UnlimitedY/wireless_neural_signal_recording_mouse/README.md

# wireless_neural_signal_recording_mouse
