UnlimitedY/wireless_neural_signal_recording_mouse/wireless_headstage_omnetics_PCB/nrf贴片omnetics 20250423/nrf贴片omnetics/器件方向.docx

U6：右上

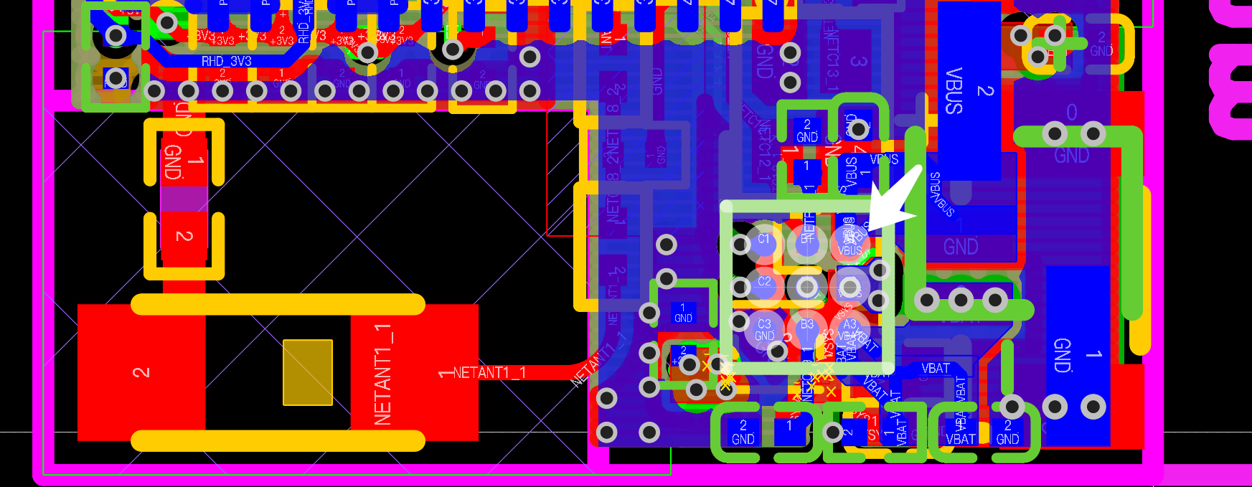
[picture p11: figure]

U1：右下

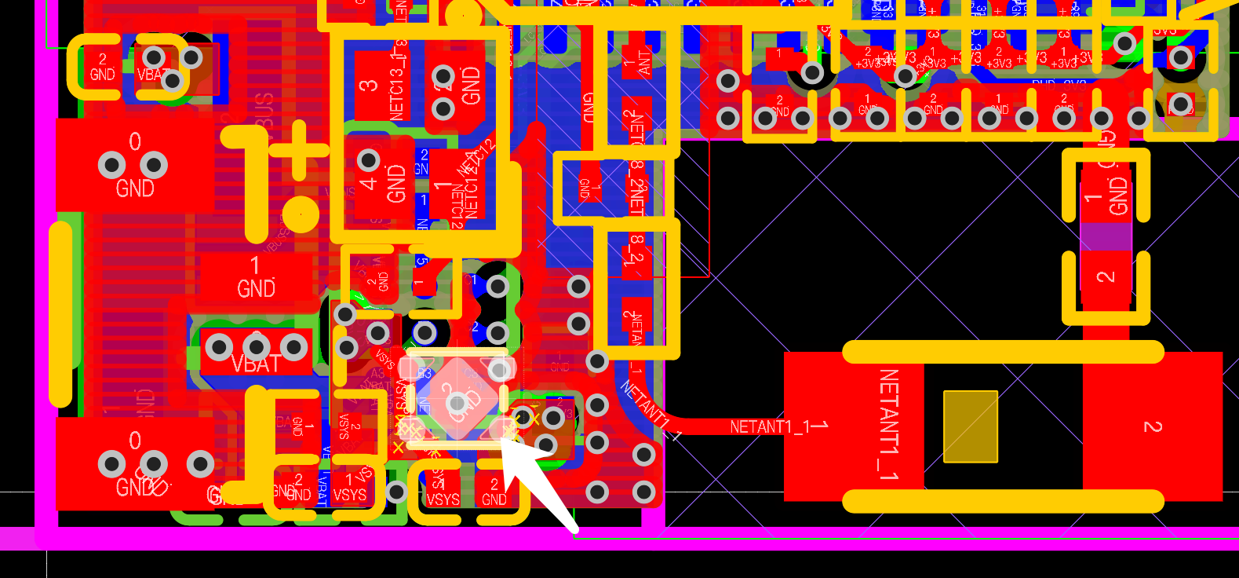
[picture p12: figure]

U2： 左下

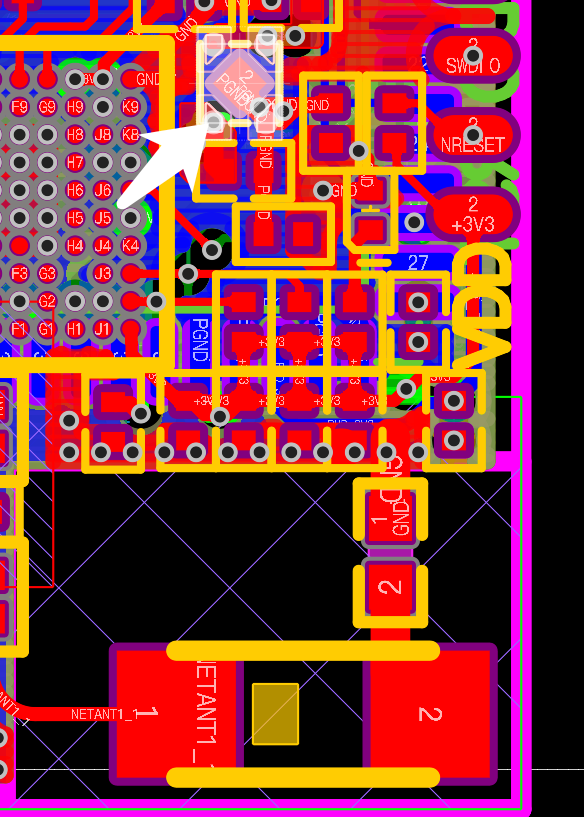
[picture p13: figure]

LED1：RED

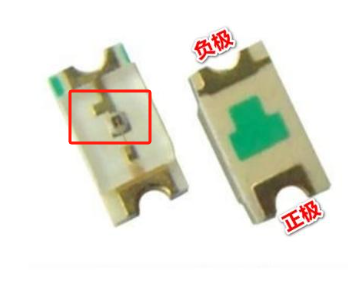
[picture p14: figure]
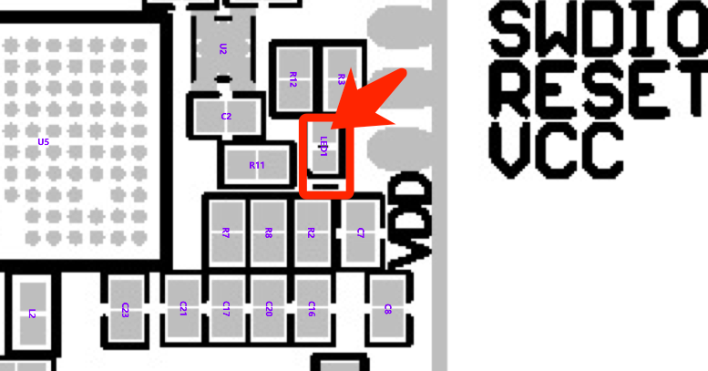
[picture p15: figure]

LED2：Blue or Green

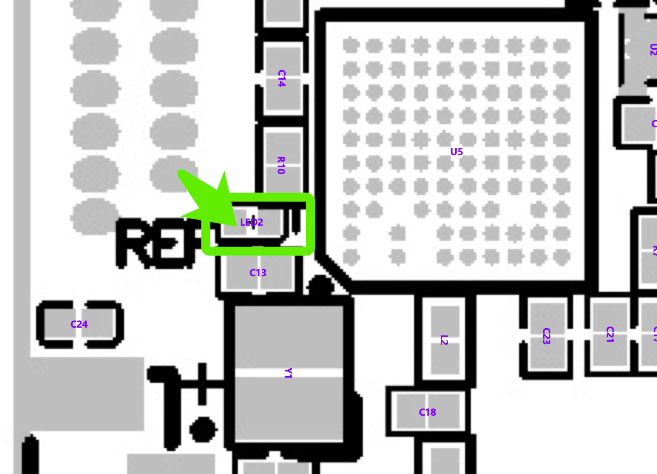
[picture p16: figure]
