UnlimitedY/wireless_neural_signal_recording_mouse/GUI/QtESBV4/Pre-experiements-behavioral-task/DBRuleSwitch/readme.txt

对于研究全天候的学习过程
需要trial的结构在整个学习过程中不发生改变

这里的范式通过提前训练一个 attend location范式来让小鼠
完成trial结构的学习并熟悉后续的freq 刺激
【inhibitation 过程，只要放进去就持续有三个led亮，出来就不亮， go cue
3KHz，对于sample period的抑制也慢慢增加时间来训练，从100ms到500ms；
增加delay 的随机性，不要固定在200ms】

之后主要关心从attend to location 到 attend to freq (5个contrasts，8~32KHz)
 的过程作为研究
学习过程主要的数据来源和attend to reverse freq的过程（这段时间
trial 结构没有发生变化，数据更加的稳定）

加入catch trials和 contrast
1. baseline trial （no sample no reward； 5%）,trial block中第一个trial
2. catch trial（contrast 为 0 ，random reward对于freq 刺激，在一开始就加入
70% perf threshold）

使用antibias （60%概率复制上一个 最简单的error trials 的所有参数 ）
Testing protocol 直接使用random
