UnlimitedY/wireless_neural_signal_recording_mouse/GUI/QtESBV4/ThermalSupervisor/mlx90640-mini热像仪采集记录仪新/Ubuntu20(AMD64)/ubuntu运行软件简要说明.docx

运行软件 切换到root 需要获取串口信息前提

sudo ./AppRun

安装CH340驱动

sudo make

sudo make install

echo $? 看下返回0 安装成功

lsusb 看下有没有串口设备 前提插入了电脑USB

打开软件，第一次运行会隐藏功能界面， 点上面 软件配置， 去掉所有勾选。
