UnlimitedY/wireless_neural_signal_recording_mouse/wireless_headstage_omnetics_PCB/nrf贴片omnetics 20250423/nrf贴片omnetics/BOM_Power_rhd2132_20250418_2025-04-23.xlsx

Sheet: bom模板
 |  |  |  | Bill of Materials | BOM_Power_rhd2132_20250418_2025-04-23
 |  |  |  | Project Title： | NRF-RHD_V0.3_1813 200250418
 |  |  |  | Variant:
 |  |  |  | Report Time： | 2025年4月23日 14:12:39
No. | Quantity | Comment | Designator | Footprint | Value | Manufacturer Part | Manufacturer | Supplier Part | Supplier | LCSC Price | Total
1 | 1 | ANT1 | ANT1 | ANT-SMD_2P-L3.20-W1.60 |  |  |  |  |  |  | #VALUE!
2 | 4 | 1uF | C1, C2, C3, C4 | C 0201_L |  |  |  |  |  |  | #VALUE!
3 | 3 | 0.1uF/16V | C5, C8, C9 | C 0201_L |  |  |  |  |  |  | #VALUE!
4 | 1 | 1uF/16V | C6 | C 0201_L |  |  |  |  |  |  | #VALUE!
5 | 1 | 10nF | C7 | C 0201_L |  |  |  |  |  |  | #VALUE!
6 | 2 | 100nF | C10, C11 | C 0201_L |  |  |  |  |  |  | #VALUE!
7 | 2 | 12pF | C12, C13 | C 0201_L |  |  |  |  |  |  | #VALUE!
8 | 2 | 1.0uF | C14, C17 | C 0201_L |  |  |  |  |  |  | #VALUE!
9 | 4 | 0.1uF | C15, C16, C21, C22 | C 0201_L |  |  |  |  |  |  | #VALUE!
10 | 1 | 1.0pF | C18 | C 0201_L |  |  |  |  |  |  | #VALUE!
11 | 1 | 4.7uF | C20 | C 0201_L |  |  |  |  |  |  | #VALUE!
12 | 1 | 820pF | C23 | C 0201_L |  |  |  |  |  |  | #VALUE!
13 | 2 | 4.7uF | C24, C26 | 0201(C) |  |  |  |  |  |  | #VALUE!
14 | 3 | 0.1uF | C25, C27, C29 | 0201(C) |  |  |  |  |  |  | #VALUE!
15 | 1 | 2.2uF/35V | C28 | 0201(C) |  |  |  |  |  |  | #VALUE!
16 | 1 | B79038 | J1 | B79038 |  |  |  |  |  |  | #VALUE!
17 | 1 | 4.7nH | L1 | L0201 |  |  |  |  |  |  | #VALUE!
18 | 1 | 3.9nH | L2 | L0201 |  |  |  |  |  |  | #VALUE!
19 | 2 | RED & Green | LED1, LED2 | LED-SMD_L0.7-W0.4-RD_BLUE - duplicate |  |  |  |  |  |  | #VALUE!
20 | 1 | power | P1 | CONN-SMD_SM02B-SURS-TF-LF-SN - duplicate |  |  |  |  |  |  | #VALUE!
21 | 1 | power | P2 | HDR-SMD_2P-P1.27-V-M-LS4.2-R1 |  |  |  |  |  |  | #VALUE!
22 | 4 | 10K | R2, R7, R8, R10 | R 0201_L |  |  |  |  |  |  | #VALUE!
23 | 1 | 100K | R3 | R 0201_L |  |  |  |  |  |  | #VALUE!
24 | 4 | 33o | R4, R5, R6, R9 | R 0201_L |  |  |  |  |  |  | #VALUE!
25 | 2 | 0R | R11, R12 | R 0201_L |  |  |  |  |  |  | #VALUE!
26 | 1 | 0R | R13 | 0402(R) |  |  |  |  |  |  | #VALUE!
27 | 1 | 1M | R14 | 0201(R) |  |  |  |  |  |  | #VALUE!
28 | 1 | NTC-10K | R15 | 0201(R) |  |  |  |  |  |  | #VALUE!
29 | 2 | TPS7A2033PDQNR | U1, U2 | X2SON-0.4 |  |  |  |  |  |  | #VALUE!
30 | 1 | RHD2132 | U3 | QFN-56-9mm |  |  |  |  |  |  | #VALUE!
31 | 1 | LSM6DS3TR | U4 | LAG-14 |  |  |  |  |  |  | #VALUE!
32 | 1 | NRF52840-CKAA-R7 | U5 | BGA94C35P10X10_354X361X51 |  |  |  |  |  |  | #VALUE!
33 | 1 | MP2710GC-0000 | U6 | WLCSP3*3-P0.5mm |  |  |  |  |  |  | #VALUE!
34 | 1 | 32MHz | Y1 | OSC 1612-4P |  |  |  |  |  |  | #VALUE!
35 | #VALUE!

Sheet: Field汇总
Project Title | NRF-RHD_V0.3_1813 200250418
Borard Title | Power
Schematic Title
PCB Title | rhd2132_20250418
Variant Name
Total Quantity | 57
Report Time | 14:12:39
Report Date | 2025年4月23日
Report Date&Time | 2025年4月23日 14:12:39
File Name | BOM_Power_rhd2132_20250418_2025-04-23
Filter Option | Add into BOM:no;
