UnlimitedY/wireless_neural_signal_recording_mouse/GUI/QtESBV4/ThermalSupervisor/mlx90640-mini热像仪采集记录仪新/模块数据手册/3DSTL/PCB2.step

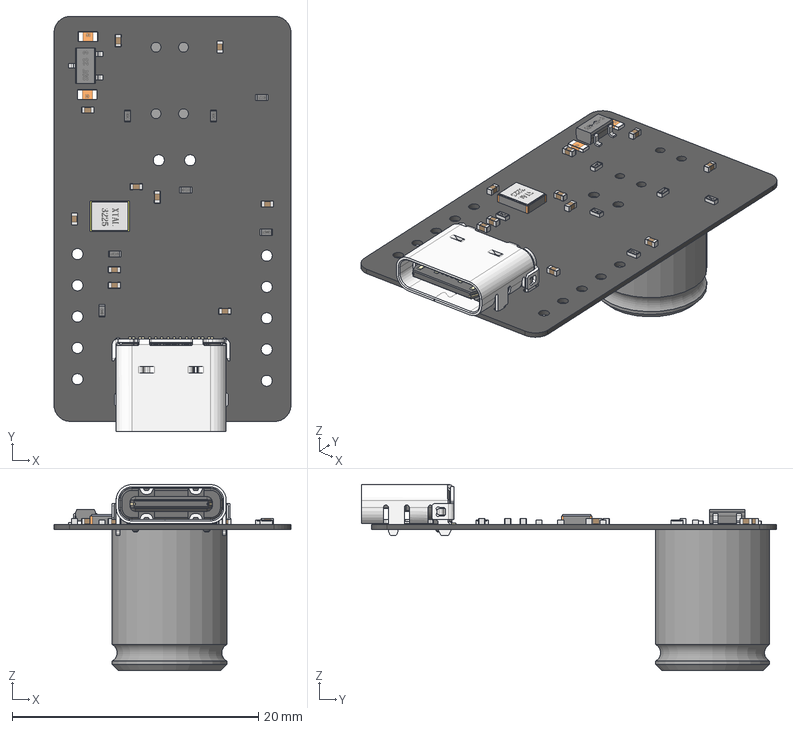
[picture p17: CAD file, 2026-01-29]
GUI/QtESBV4/ThermalSupervisor/mlx90640-mini热像仪采集记录仪新/模块数据手册/3DSTL/PCB2.step
19.2 x 33.7 x 15.1 mm
