UnlimitedY/wireless_neural_signal_recording_mouse/GUI/QtESBV4/ThermalSupervisor/mlx90640-mini热像仪采集记录仪新/模块数据手册/3DSTL/477787072570855504.step

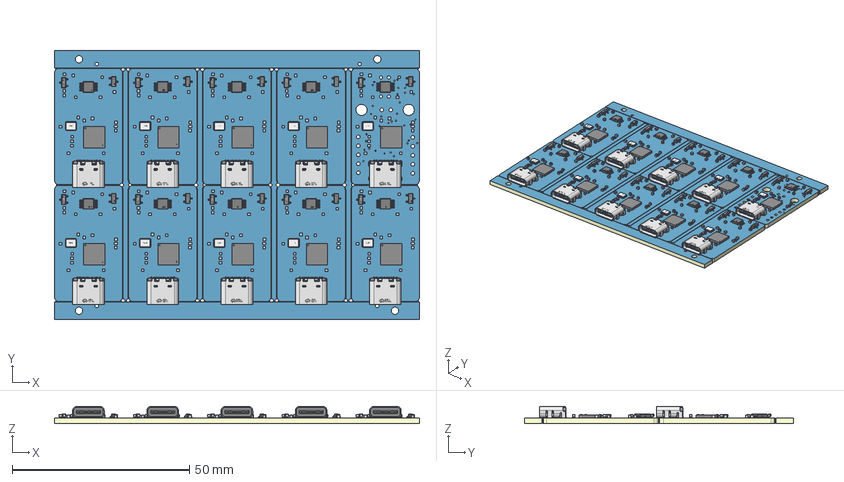
[picture p18: CAD file, 2026-01-29]
GUI/QtESBV4/ThermalSupervisor/mlx90640-mini热像仪采集记录仪新/模块数据手册/3DSTL/477787072570855504.step
103.1 x 75.9 x 4.85 mm
Board~Kfwh
TopCopper~Kfwh
BottomCopper~Kfwh
TopFpcStiffener~Kfwh
BottomFpcStiffener~Kfwh
C2~0603~ac9b32e974bc448eab36b1293f859dcb~Kfwh x 20
C6~0402~32fe2cf9314f444ca2785a33c2db7189~Kfwh x 100
R7~0402~026a4a15ab5c4a92ac0e421d6d013717~Kfwh x 70
SOT-23-3~d777607a152f4f3aac9bb0d0c14ed6fd~Kfwh x 10
SOT-23~d777607a152f4f3aac9bb0d0c14ed6fd~Kfwh x 10
SMD~954b2a5828604707b62aef0fe6e7695f~Kfwh x 10
QFN-36-EP(6x6)~9249f52d05404403ac352f33043cef56~Kfwh x 10
0402~ccb4f96094b249eaba587e4fe24b6f07~Kfwh x 10
MSOP-10~a8ab40c7a7c54773a59b712bf86c7131~Kfwh x 10
SMD3225-4P~02485e56ba8d4732a26526d2983fc729~Kfwh x 10
