UnlimitedY/wireless_neural_signal_recording_mouse/wireless_headstage_omnetics_PCB/nrf贴片omnetics 20250423/nrf贴片omnetics/rhd2132_20250418_装配图.pdf

# 时间：2025-04-23装配图纸_top

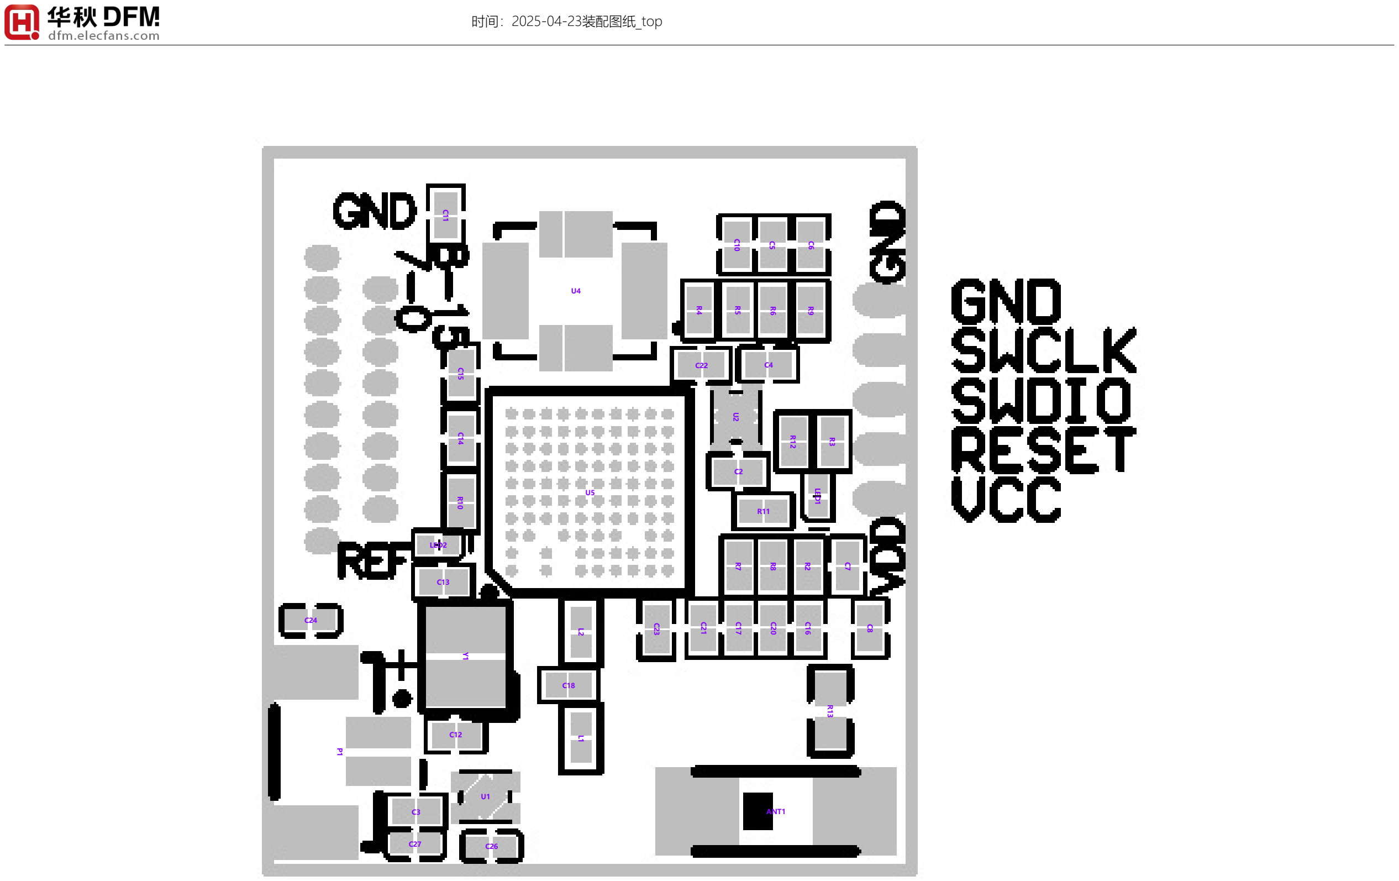
[picture p19: page 1]

ANT1

C10

C11 C12

C13

C14 C15

C16

C17

C18

C2

C20

C21 C22

C23

C24

C26 C27

C3

C4

C5

C6

C7

C8
L1 L2

LED1

LED2

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
# 时间：2025-04-23装配图纸_bot

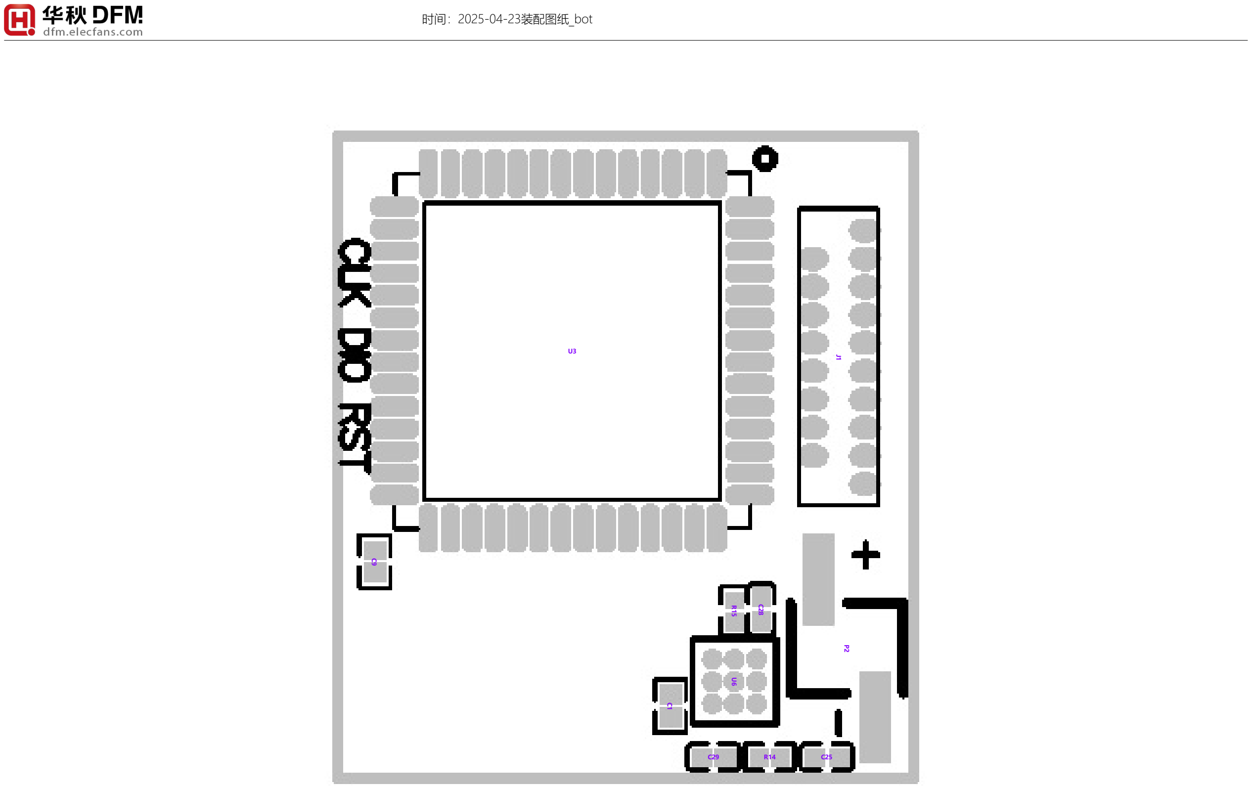
[picture p20: page 2]

C1

C25

C28

C29

C9

J1 P2

R14

R15

U3

U6
