UnlimitedY/wireless_neural_signal_recording_mouse/other_maybe_useful/NRF_RHD2132_1813.pdf

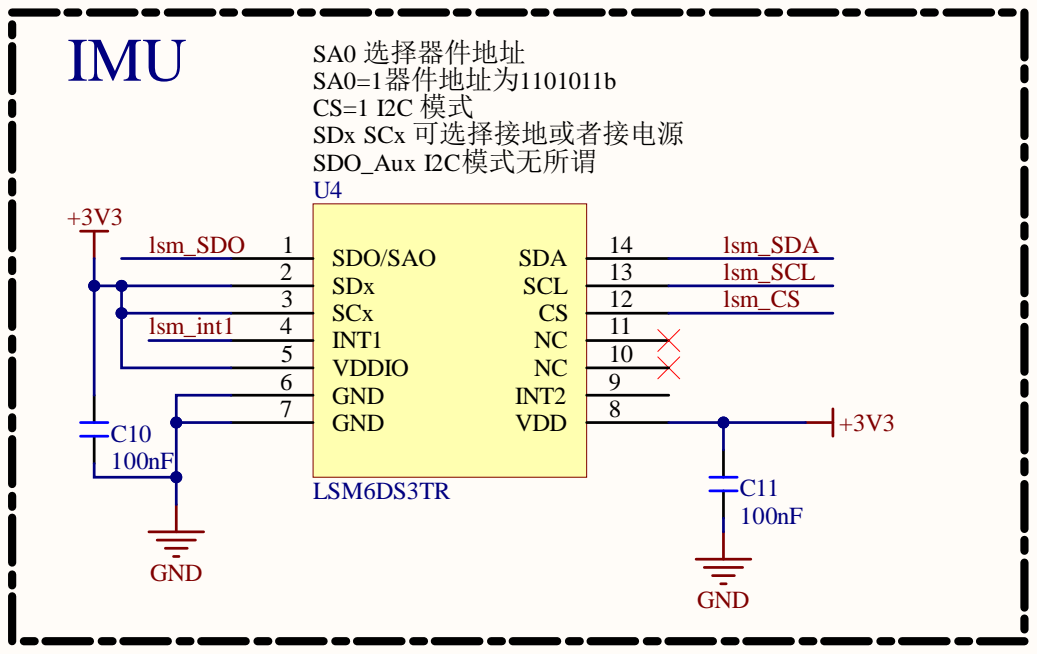
[picture p21: page 1]

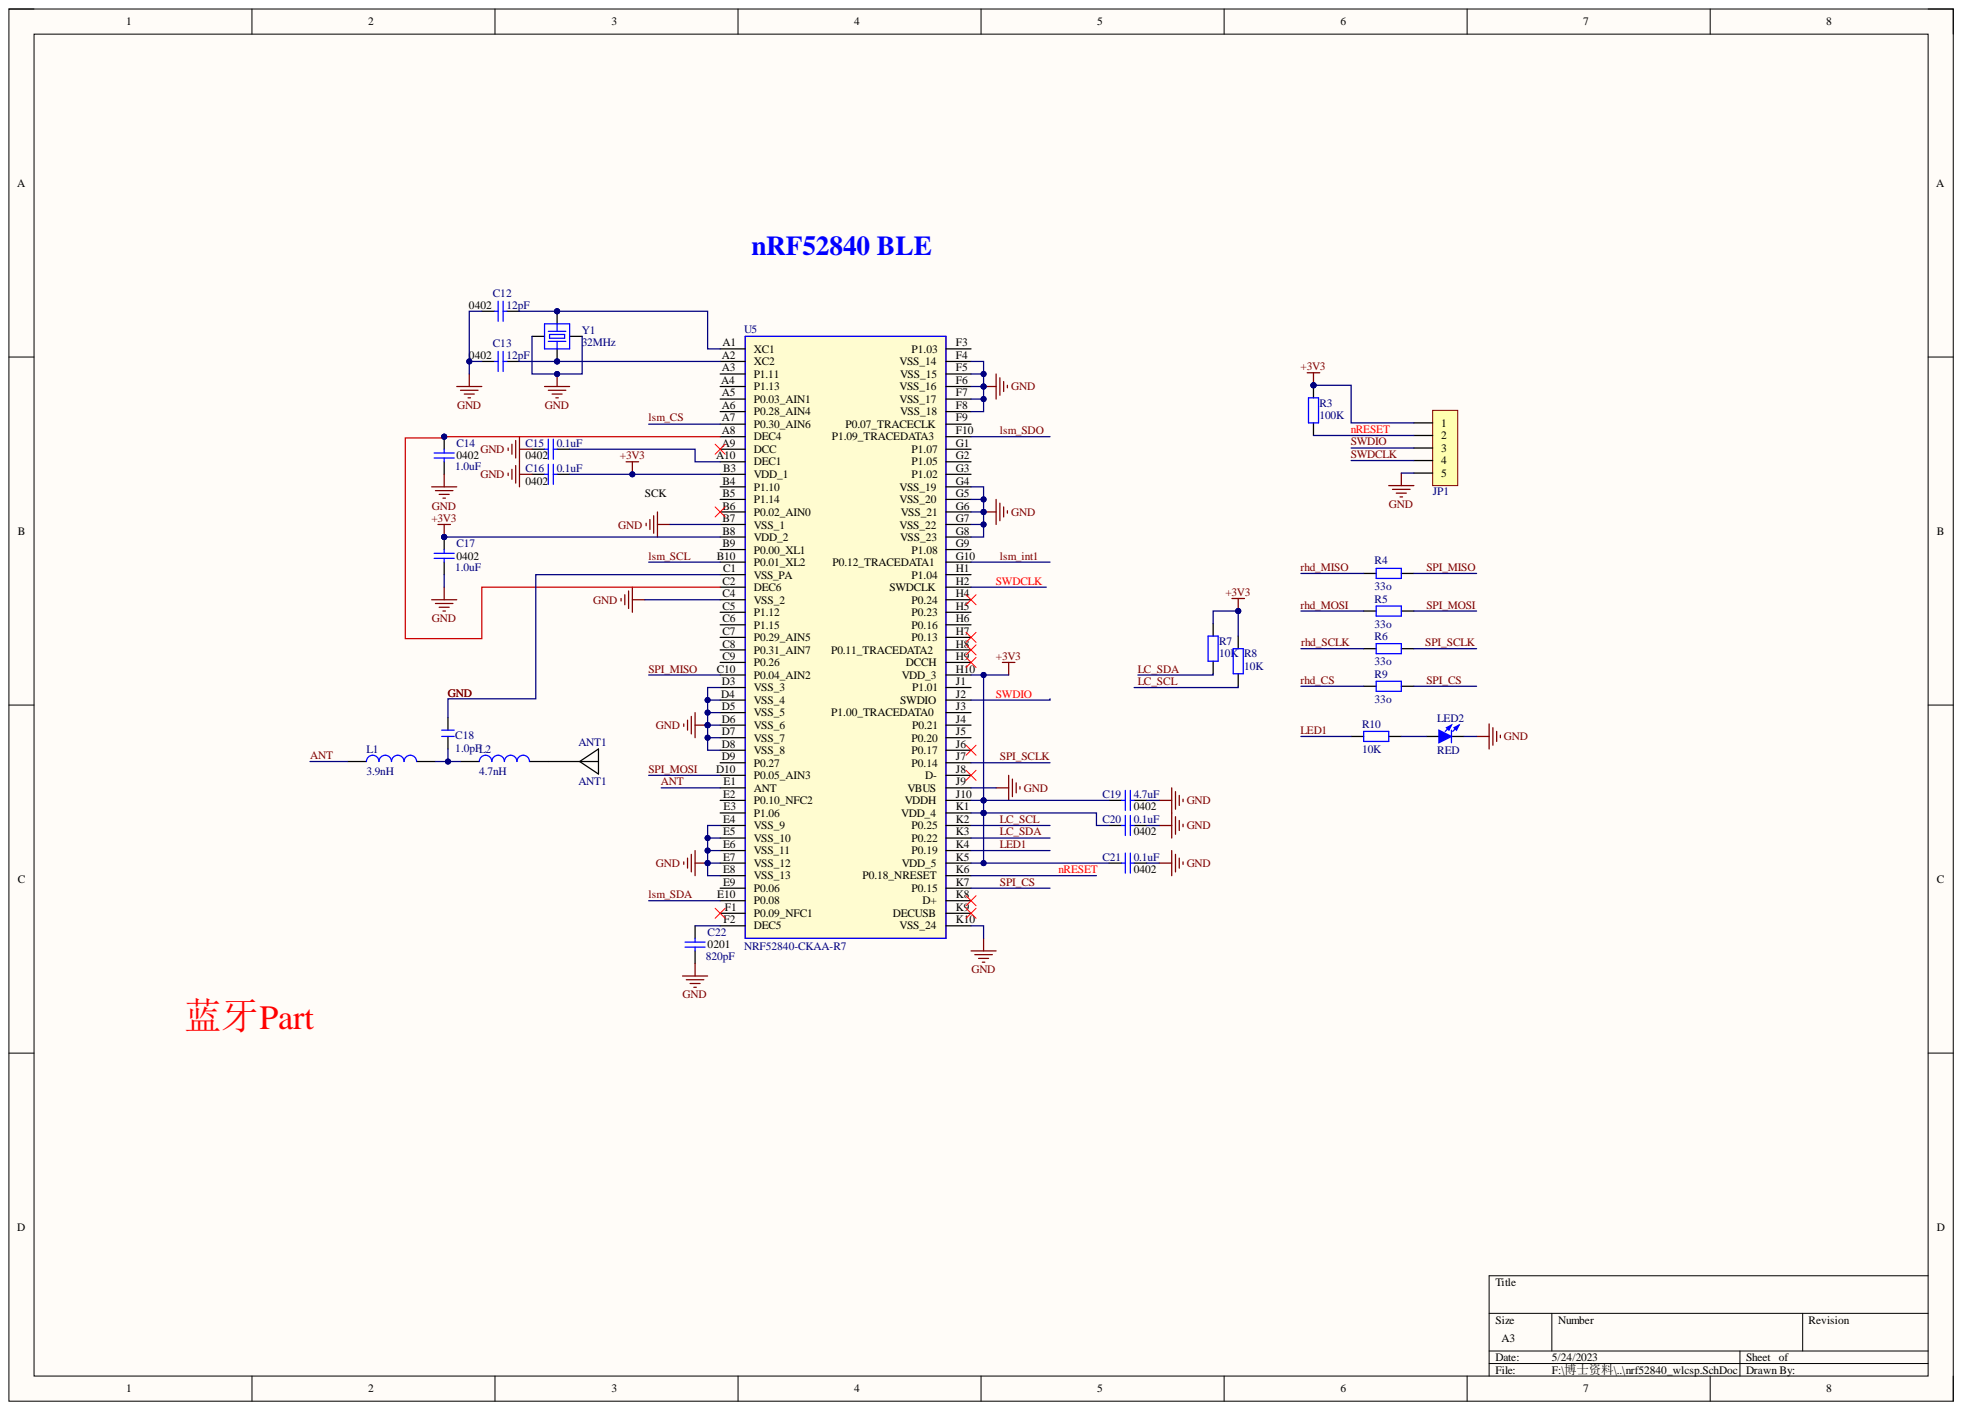
[picture p22: page 2]

C 2
C 4

SPI_M ISO | C 5 | | H 5

C 7 | | H 7
C 8 | | H 8
C 9 | | H 9
C10 | | H10
D 3 | | J 1

D 4 | | J 2 J 3
D 5
D 6 | | J 4
D 7 | | J 5

J10
K 1
K 2 | LC_SC L

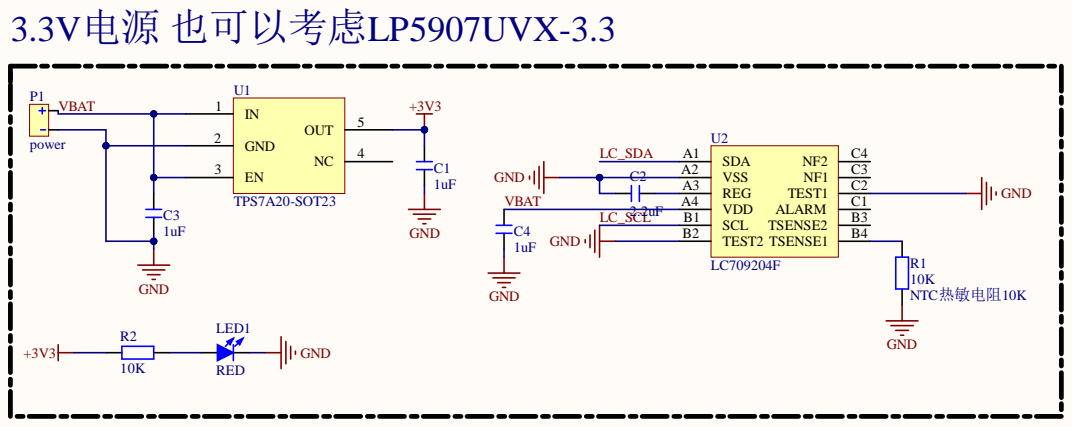
[picture p23: page 3]

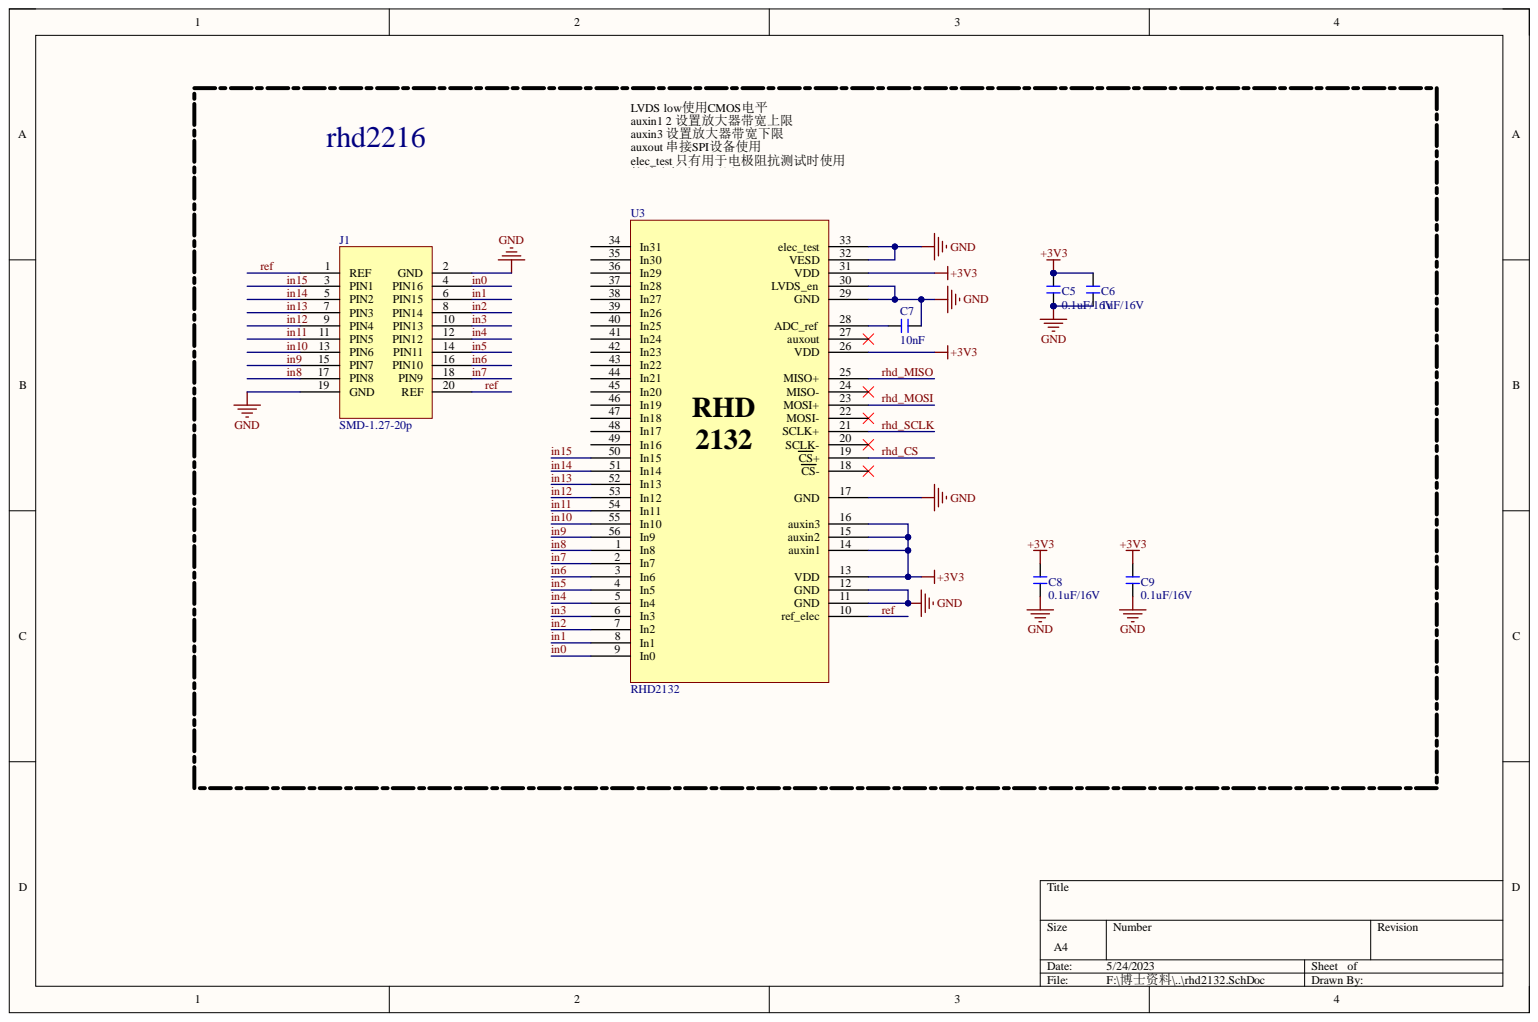
[picture p24: page 4]

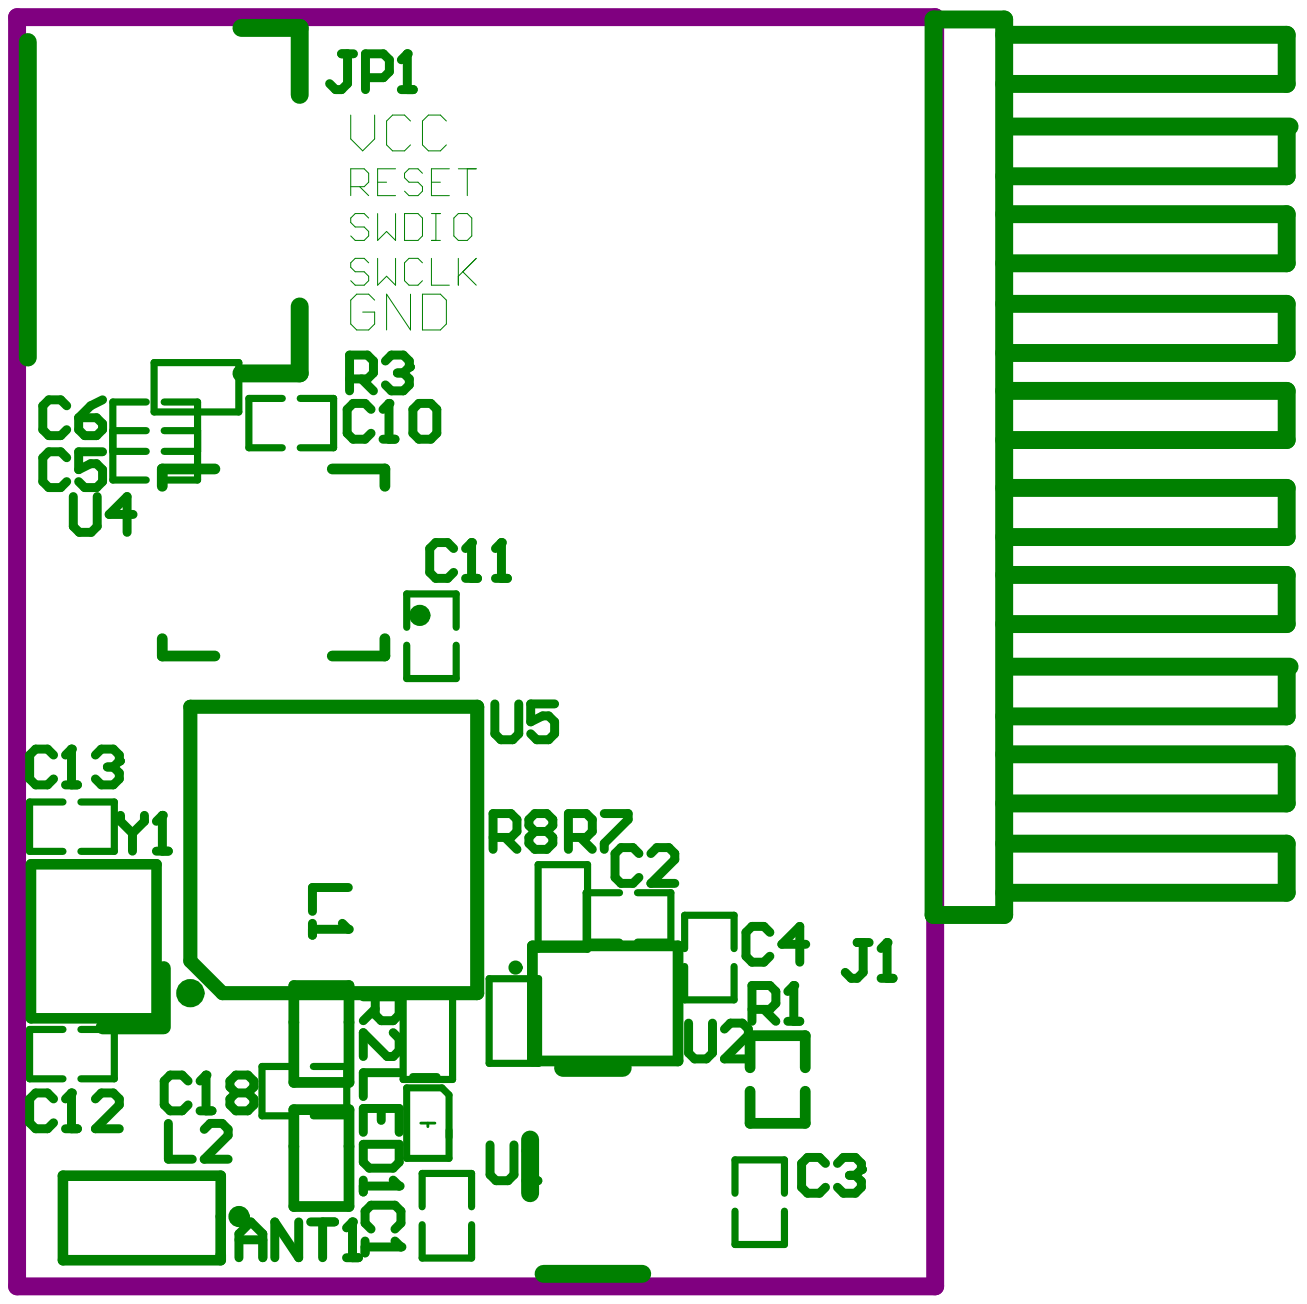
[picture p25: page 5]

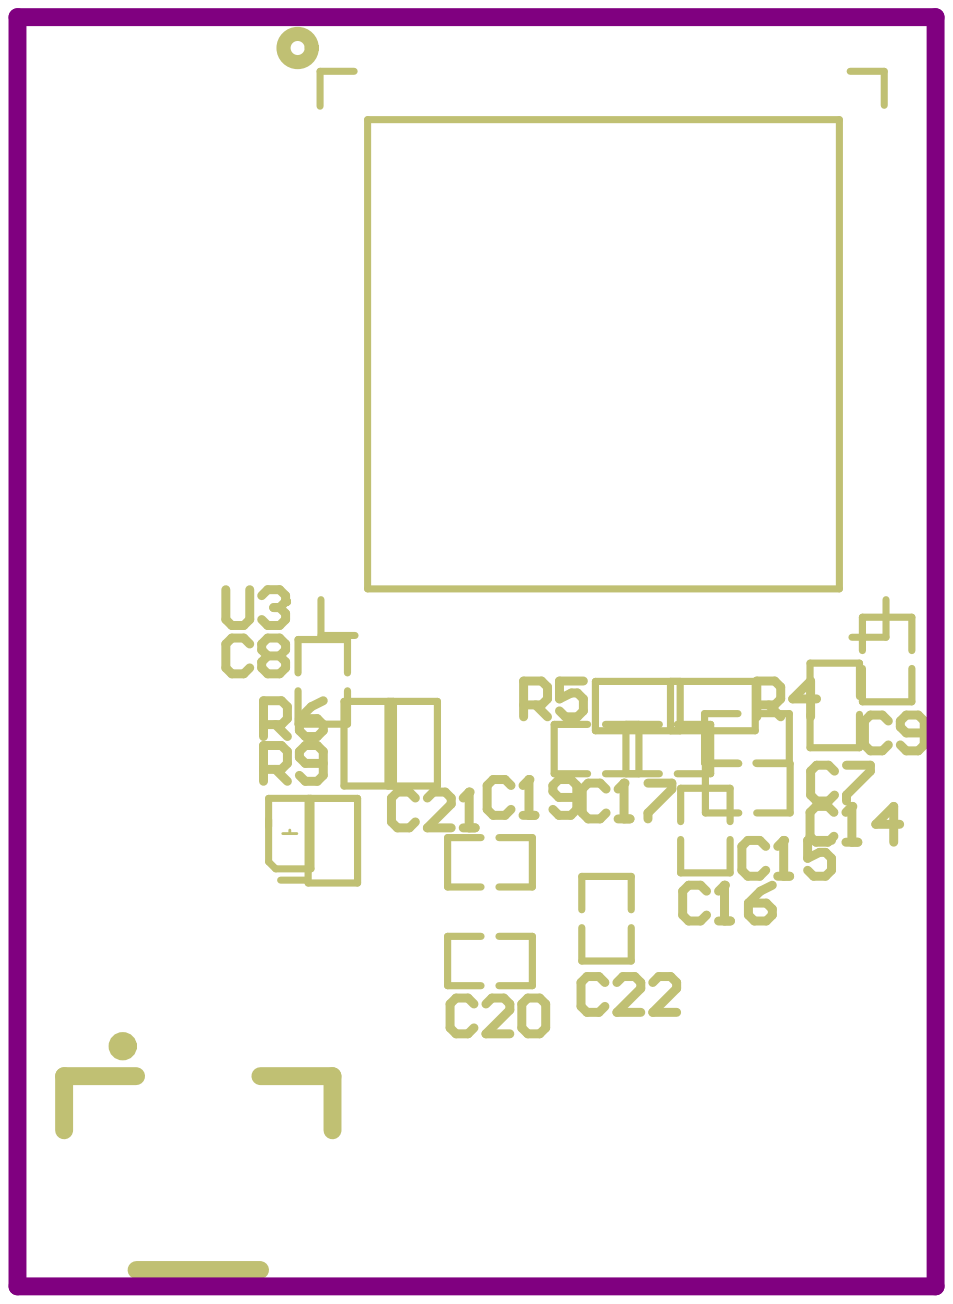
[picture p26: page 6]
