UnlimitedY/wireless_neural_signal_recording_mouse/(list of files, drawings)

Other design files:
other_maybe_useful/WPT_FPC_XCM_Change(1)(1).pcbdoc
wireless_headstage_omnetics_PCB/nrf贴片omnetics 20250423/nrf贴片omnetics/pcb&sch/IMU.SchDoc
wireless_headstage_omnetics_PCB/nrf贴片omnetics 20250423/nrf贴片omnetics/pcb&sch/nrf52840_wlcsp.SchDoc
wireless_headstage_omnetics_PCB/nrf贴片omnetics 20250423/nrf贴片omnetics/pcb&sch/NRF_RHD2132_1813_YBW.PrjPcb
wireless_headstage_omnetics_PCB/nrf贴片omnetics 20250423/nrf贴片omnetics/pcb&sch/Power.SchDoc
wireless_headstage_omnetics_PCB/nrf贴片omnetics 20250423/nrf贴片omnetics/pcb&sch/rhd2132.SchDoc
wireless_headstage_omnetics_PCB/nrf贴片omnetics 20250423/nrf贴片omnetics/pcb&sch/rhd2132_20250418.PcbDoc
