UnlimitedY/wireless_neural_signal_recording_mouse/firmware/pripherial/Sensor_recording/LSM6DS3.c

/**
 * LSM6DS3.h
 *
 * nRF52 TWI interface for LSM6DS3 IMU.
 *
 * Electronut Labs
 * electronut.in
 */

#include "stdlib.h"
#include "time.h"
#include "LSM6DS3.h"

/**
 * @brief function to test availablility of IMU by reading WHO_AM_I register.
 */
int LSM6DS3_who_am_i(void)
{
  nrfx_err_t err_code;
  uint8_t who_am_i = 10;
  bool is_busy = 1;
  err_code = data_read(WHO_AM_I, &who_am_i, 1, 1);

  if(who_am_i !=0x6A){
    return who_am_i;
  }else{
    return -1;
  }
  // return err_code;
  // APP_ERROR_CHECK(err_code);
}


/**
 * @brief function to initialize IMU sensor.
 */
uint8_t LSM6DS3_init(void)
{
  uint8_t err_code;
  settings.accel_range            = 2;      // Full Scale(FS) range (in g). Select from: 2, 4, 8, 16
  settings.accel_samplerate       = 104;    // Hz. Select from: 13, 26, 52, 104, 208, 416, 833, 1666
  settings.accel_bandwidth        = 400;    // Hz. Select from: 50, 100, 200, 400
  settings.accel_FIFO_enable      = 0;      // Set to include accelerometer data in FIFO buffer
  settings.accel_FIFO_decimation  = 0;      // Set to activate.

  settings.gyro_range             = 500;   // Angular Rate range (in deg/s).  Can be: 125, 245, 500, 1000, 2000
	settings.gyro_samplerate        = 104;    // Hz. Select from: 13, 26, 52, 104, 208, 416, 833, 1666
	settings.gyro_bandwidth         = 400;    // Hz. Select from: 50, 100, 200, 400;
	settings.gyro_FIFO_enable       = 0;      // Set to include gyroscope data in FIFO buffer
	settings.gyro_FIFO_decimation   = 0;      // Set to activate.

	settings.temp_enable            = 0;      // Set to activate temperature measure

	//FIFO control data
	settings.FIFO_threshold 			  = 3000;    //Can be 0 to 4096 (16 bit bytes)
	settings.FIFO_samplerate 		    = 13;     //default 13Hz
	settings.FIFO_mode 			        = 6;      //Default off

  // 注意： 这里要disable iic 的bus ，否则会导致漏电功耗上升
  uint8_t tx_data[2] = {MASTER_CONFIG, 0x00};
  err_code = data_write(tx_data[0] ,&tx_data[1], 1, 1);
  // set IF_INC in CTRL3_C register. set BDU : block mode for low-power
  tx_data[0] = CTRL3_C;
  tx_data[1] = 0x44;
  err_code = data_write(tx_data[0], &tx_data[1] ,1, 1);

  err_code = LSM6DS3_config();
  return err_code;
}

/**
 * @brief function to configure IMU parameters.
 *
 * Accelerometer parameters are configured using CTRL1_XL register.
 * Bit[1:0] are reserved for filter bandwidth selection. Values can be 400 Hz, 200 Hz, 100 Hz and 50 Hz
 * Bit[3:2] are reserved for full scale range selection. Values can be (+/-)2g, (+/-)4g, (+/-)8g and (+/-)16g
 * Bit[7:4] are reserved for output data rate and power mode selection.
 *
 * Gyroscope parameters are configured using CTRL2_G registers.
 * Bit[1] is reserved for full scale range selection at 125 dps.
 * Bit[3:2] are reserved for full scale range sselection from 245 dps, 500 dps, 1000 dps and 2000 dps
 * Bit[7:4] are reserved for output data rate selection.
 */
uint8_t LSM6DS3_config(void)
{
  nrfx_err_t err_code;
  uint8_t tx_data[2];

  // configure accelerometer
  tx_data[0] = CTRL1_XL;
  tx_data[1] = 0;
  if(settings.accel_enable == 1) {
    // Bandwidth lowpass filter
    switch(settings.accel_bandwidth) {
      case 50:
              tx_data[1] |= LSM6DS3_IMU_BW_XL_50Hz;
              break;

      case 100:
              tx_data[1] |= LSM6DS3_IMU_BW_XL_100Hz;
              break;

      case 200:
              tx_data[1] |= LSM6DS3_IMU_BW_XL_200Hz;
              break;

      default:
      case 400:
              tx_data[1] |= LSM6DS3_IMU_BW_XL_400Hz;
              break;
    }

    // Full scale range
    switch(settings.accel_range) {
      case 2:
              tx_data[1] |= LSM6DS3_IMU_FS_XL_2g;
              break;

      case 4:
              tx_data[1] |= LSM6DS3_IMU_FS_XL_4g;
              break;

      case 8:
              tx_data[1] |= LSM6DS3_IMU_FS_XL_8g;
              break;

      default:
      case 16:
              tx_data[1] |= LSM6DS3_IMU_FS_XL_16g;
              break;
    }

    // ODR
    switch(settings.accel_samplerate) {

      case 0:
              tx_data[1] |= LSM6DS3_IMU_ODR_XL_POWER_DOWN;
              break;

      case 13:
              tx_data[1] |= LSM6DS3_IMU_ODR_XL_13Hz;
              break;

      case 26:
              tx_data[1] |= LSM6DS3_IMU_ODR_XL_26Hz;
              break;

      case 52:
              tx_data[1] |= LSM6DS3_IMU_ODR_XL_52Hz;
              break;

      default:
      case 104:
              tx_data[1] |= LSM6DS3_IMU_ODR_XL_104Hz;
              break;

      case 208:
              tx_data[1] |= LSM6DS3_IMU_ODR_XL_208Hz;
              break;

      case 416:
              tx_data[1] |= LSM6DS3_IMU_ODR_XL_416Hz;
              break;

      case 833:
              tx_data[1] |= LSM6DS3_IMU_ODR_XL_833Hz;
              break;

      case 1660:
              tx_data[1] |= LSM6DS3_IMU_ODR_XL_1660Hz;
              break;

      case 3330:
              tx_data[1] |= LSM6DS3_IMU_ODR_XL_3330Hz;
              break;

      case 6660:
              tx_data[1] |= LSM6DS3_IMU_ODR_XL_6660Hz;
              break;
    }
  }
  else {
    tx_data[1] = 0;
  }

  err_code = data_write(tx_data[0], &tx_data[1] ,1, 1);

  // configure gyroscope
  tx_data[0] = CTRL2_G;
  tx_data[1] = 0;
  if(settings.gyro_enable == 1) {
    // range
    switch(settings.gyro_range) {
      case 125:
              tx_data[1] |= LSM6DS3_IMU_FS_125_ENABLED;
              break;

      case 245:
              tx_data[1] |= LSM6DS3_IMU_FS_G_245dps;
              break;

      case 500:
              tx_data[1] |= LSM6DS3_IMU_FS_G_500dps;
              break;

      case 1000:
              tx_data[1] |= LSM6DS3_IMU_FS_G_1000dps;
              break;

      default:
      case 2000:
              tx_data[1] |= LSM6DS3_IMU_FS_G_2000dps;
              break;
    }

    // ODR
    switch(settings.gyro_samplerate) {
      case 13:
              tx_data[1] |= LSM6DS3_IMU_ODR_G_13Hz;
              break;

      case 26:
              tx_data[1] |= LSM6DS3_IMU_ODR_G_26Hz;
              break;

      case 52:
              tx_data[1] |= LSM6DS3_IMU_ODR_G_52Hz;
              break;

      default:
      case 104:
              tx_data[1] |= LSM6DS3_IMU_ODR_G_104Hz;
              break;

      case 208:
              tx_data[1] |= LSM6DS3_IMU_ODR_G_208Hz;
              break;

      case 416:
              tx_data[1] |= LSM6DS3_IMU_ODR_G_416Hz;
              break;

      case 833:
              tx_data[1] |= LSM6DS3_IMU_ODR_G_833Hz;
              break;

      case 1660:
              tx_data[1] |= LSM6DS3_IMU_ODR_G_1660Hz;
              break;
    }
  }
  else {
    tx_data[1] = 0;
  }

  err_code = data_write(tx_data[0], &tx_data[1] ,1, 1);
  
  if(settings.accel_enable){
    LSM6DS3_set_accel_normal_mode(settings.accel_samplerate);
  }else{
    LSM6DS3_set_accel_power_down_mode();
  }

  if(settings.gyro_enable){
    LSM6DS3_set_gyro_active_mode();
  }else{
    LSM6DS3_set_gyro_sleep_mode();
  }
  uint8_t config_return = 0;

  return config_return;
}


void LSM6DS3_accel_enable(void)
{
}

void LSM6DS3_gyro_enable(void)
{
}

/**
 * @brief function to enable power down mode in accelerometer
 *
 * setting ODR_XL[3:0] in CTRL1_XL register to 0 enables power-down mode.
 */
void LSM6DS3_set_accel_power_down_mode()
{
  nrfx_err_t err_code;
  uint8_t rx_data;
  uint8_t tx_data[2] = {CTRL1_XL, 0};

  // read CTRL1_XL register to obtain current parameters.
  // err_code = data_read(CTRL1_XL, &rx_data, sizeof(rx_data), 1);
  err_code = data_read(CTRL1_XL, &rx_data, sizeof(rx_data), 1);
  
  // APP_ERROR_CHECK(err_code);

  // bit mask CTRL1_XL to avoid losing previously set parameters. Only change ODR_XL bits.
  tx_data[1] |= (0x00 << 4) | (rx_data & 0x0F);

  err_code = data_write(tx_data[0], &tx_data[1] ,1, 1);
  // APP_ERROR_CHECK(err_code);
}

/**
 * @brief function to enable low power mode in accelerometer
 *
 * Low power mode is enabled by setting one of the following ODR values: 13 Hz, 26Hz and 52 Hz
 */
void LSM6DS3_set_accel_low_power_mode(uint16_t value)
{
  nrfx_err_t err_code;
  uint8_t rx_data;
  // uint8_t tx_data[2] = {CTRL1_XL, 0};
  uint8_t tx_data[2];

  // set XL_HM_MODE bit to 1 in CTRL6_C to enable high performance mode.
  tx_data[0] = CTRL6_C;
  tx_data[1] = 0x10;

  err_code = data_write(tx_data[0], &tx_data[1] ,1, 1);
  // APP_ERROR_CHECK(err_code);


  // read CTRL1_XL register to obtain current parameters.
  // err_code = data_read(CTRL1_XL, &rx_data, sizeof(rx_data), 1);
  err_code = data_read(CTRL1_XL, &rx_data, sizeof(rx_data), 1);
  // APP_ERROR_CHECK(err_code);

  tx_data[0] = CTRL1_XL;
  // bit mask CTRL1_XL to avoid losing previously set parameters. Only change ODR_XL bits.
  switch(value) {
    case 13:
      tx_data[1] |= (0x01 << 4) | (rx_data & 0x0F);
      break;

    case 26:
      tx_data[1] |= (0x02 << 4) | (rx_data & 0x0F);
      break;

    default:
    case 52:
      tx_data[1] |= (0x03 << 4) | (rx_data & 0x0F);
      break;
  }

  // err_code = data_write(tx_data[0], &tx_data[1] ,1, 1);
  err_code = data_write(tx_data[0], &tx_data[1] ,1, 1);
  // APP_ERROR_CHECK(err_code);
}

/**
 * @brief function to enable normal mode in accelerometer
 *
 * Normal mode is enabled by setting one of the following ODR values: 104 Hz and 208 Hz
 */
void LSM6DS3_set_accel_normal_mode(uint16_t value)
{
  nrfx_err_t err_code;
  uint8_t rx_data;
  // uint8_t tx_data[2] = {CTRL1_XL, 0};
  uint8_t tx_data[2];

  // set XL_HM_MODE bit to 1 in CTRL6_C to disable high performance mode.
  tx_data[0] = CTRL6_C;
  tx_data[1] = 0x10;

  err_code = data_write(tx_data[0], &tx_data[1] ,1, 1);
  // APP_ERROR_CHECK(err_code);

  // read CTRL1_XL register to obtain current parameters.
  err_code = data_read(CTRL1_XL, &rx_data, sizeof(rx_data), 1);
  // APP_ERROR_CHECK(err_code);

  tx_data[0] = CTRL1_XL;
  // bit mask CTRL1_XL to avoid losing previously set parameters. Only change ODR_XL bits.
  switch(value) {
    default:
    case 104:
      tx_data[1] = (0x04 << 4) | (rx_data & 0x0F);
      break;

    case 208:
      tx_data[1] = (0x05 << 4) | (rx_data & 0x0F);
      break;
  }

  err_code = data_write(tx_data[0], &tx_data[1] ,1, 1);
  // APP_ERROR_CHECK(err_code);
}

/**
 * @brief function to enable high performance mode in accelerometer
 *
 * High performance mode is enabled by setting one of the following ODR values: 416 Hz, 833 Hz, 1.66 kHz, 3.33 kHz and 6.66 kHz
 */
void LSM6DS3_set_accel_high_performance_mode(uint16_t value)
{
  nrfx_err_t err_code;
  uint8_t rx_data;
  // uint8_t tx_data[2] = {CTRL1_XL, 0};
  uint8_t tx_data[2];

  // set XL_HM_MODE bit to 1 in CTRL6_C to enable high performance mode.
  tx_data[0] = CTRL6_C;
  tx_data[1] = 0x00;

  err_code = data_write(tx_data[0], &tx_data[1] ,1, 1);
  // APP_ERROR_CHECK(err_code);

  // read CTRL1_XL register to obtain current parameters.
  err_code = data_read(CTRL1_XL, &rx_data, sizeof(rx_data), 1);
  // APP_ERROR_CHECK(err_code);

  tx_data[0] = CTRL1_XL;
  // bit mask CTRL1_XL to avoid losing previously set parameters. Only change ODR_XL bits.
  switch(value) {
    case 416:
      tx_data[1] |= (0x06 << 4) | (rx_data & 0x0F);
      break;

    case 833:
      tx_data[1] |= (0x07 << 4) | (rx_data & 0x0F);
      break;

    default:
    case 1660:
      tx_data[1] |= (0x08 << 4) | (rx_data & 0x0F);
      break;

    case 3330:
      tx_data[1] |= (0x09 << 4) | (rx_data & 0x0F);
      break;

    case 6660:
      tx_data[1] |= (0x0A << 4) | (rx_data & 0x0F);
      break;
  }

  err_code = data_write(tx_data[0], &tx_data[1] ,1, 1);
  // APP_ERROR_CHECK(err_code);
}


/**
 * @brief function to read accelerometer data
 */
// void LSM6DS3_read_accl_data(uint16_t *accl_x ,uint16_t *accl_y ,uint16_t *accl_z)
void LSM6DS3_read_accl_data()
{
  nrfx_err_t err_code;
  uint8_t data[6] = {0, 0, 0, 0 ,0 ,0};

  uint8_t status_reg;
  data_read(STATUS_REG, (uint8_t *)&status_reg, 1, 1);
  status_reg = status_reg & 0x01;
  if(status_reg){
  
    err_code = data_read(OUTX_L_XL, data, 6, 1); 
    imu_data[0] = (int16_t)data[1];
    imu_data[0] = (imu_data[0] * 256) + (int16_t)data[0];
    imu_data[1] = (int16_t)data[3];
    imu_data[1] = (imu_data[1] * 256) + (int16_t)data[2];
    imu_data[2] = (int16_t)data[5];
    imu_data[2] = (imu_data[2] * 256) + (int16_t)data[4];
  }
  
}

/**
 * @brief function to compute raw accelerometer data in g.
 *
 * Multiply linear acceleration sensitivity with raw_data. Divide the product by 1000 to obtain value in g.
 * Refer table 4.1 on page 19 of LSM6DS3 datasheet.
 */
float LSM6DS3_accelData_in_g(uint16_t raw_data)
{
  return ((float)((raw_data * 0.061 * (settings.accel_range >> 1)) / 1000 ));
}


/**
 * @brief function to enable sleep mode in gyroscope
 */
void LSM6DS3_set_gyro_sleep_mode()
{
  nrfx_err_t err_code;

  // set SLEEP_G bit in CTRL4_C register to enable sleep mode
  uint8_t tx_data[2] = {CTRL4_C, LSM6DS3_IMU_SLEEP_G_ENABLED};

  err_code = data_write(tx_data[0], &tx_data[1] ,1, 1);
  // APP_ERROR_CHECK(err_code);
}

/**
 * @brief function to disable sleep mode in gyroscope
 */
void LSM6DS3_set_gyro_active_mode()
{
  nrfx_err_t err_code;

  // reset SLEEP_G bit in CTRL4_C register to disable sleep mode
  uint8_t tx_data[2] = {CTRL4_C, LSM6DS3_IMU_SLEEP_G_DISABLED};

  err_code = data_write(tx_data[0], &tx_data[1] ,1, 1);
  // APP_ERROR_CHECK(err_code);
}

/**
 * @brief functioon to read gyroscope data.
 */
void LSM6DS3_read_gyro_data()
// void LSM6DS3_read_gyro_data(uint16_t *gyro)
{
  nrfx_err_t err_code;
  uint8_t data[6] = {0 ,0 , 0 ,0 ,0 ,0};
  uint8_t status_reg;
  data_read(STATUS_REG, (uint8_t *)&status_reg, 1, 1);
  status_reg = status_reg & 0x02;
  if(status_reg){

  err_code = data_read(OUTX_L_G, data, sizeof(data), 1); // 6 bytes ; X ,Y ,Z axis; 16bits value; 

  imu_data[3] = (int16_t)data[1];
  imu_data[3] = (imu_data[3] * 256) + (int16_t)data[0];
  imu_data[4] = (int16_t)data[3];
  imu_data[4] = (imu_data[4] * 256) + (int16_t)data[2];
  imu_data[5] = (int16_t)data[5];
  imu_data[5] = (imu_data[5] * 256) + (int16_t)data[4];
  }
}

/**
 * @brief function to compute raw gyroscope data in degrees per second (dps).
 *
 * Multiply raw data with angular rate sensitivity.
 * Refer table 4.1 on page 19 of LSM6DS3 datasheet
 */
float LSM6DS3_gyroData_in_dps(uint16_t raw_data)
{
  uint8_t gyro_range_divisor;

  if (settings.gyro_range == 245) {
    gyro_range_divisor = 2;
  }
  else {
    gyro_range_divisor = settings.gyro_range / 125;
  }

  return ((float) ((raw_data * 4.375 * gyro_range_divisor) / 1000 ));
}

/**
 * @brief function to configure FIFO
 */
void LSM6DS3_FIFO_config(void)
{
  nrfx_err_t err_code;
  uint8_t tx_data[2];

  // masking the threshold value in FIFO_CTRL1 register.
  tx_data[0] = FIFO_CTRL1;
  tx_data[1] = settings.FIFO_threshold & 0x00FF;
  err_code = data_write(tx_data[0], &tx_data[1] ,1, 1);
  // APP_ERROR_CHECK(err_code);

  // masking the threshold value in FIFO_CTRL2 register.
  tx_data[0] = FIFO_CTRL2;
  tx_data[1] = (settings.FIFO_threshold & 0x0F00) >> 8;
  err_code = data_write(tx_data[0], &tx_data[1] ,1, 1);
  // APP_ERROR_CHECK(err_code);

  // set up decimation factor for accelerometer and gyroscope
  tx_data[0] = FIFO_CTRL3;
  tx_data[1] = 0;
  if(settings.accel_FIFO_enable == 1) {
    tx_data[1] |= (settings.accel_FIFO_decimation & 0x07);
  }

  if (settings.gyro_FIFO_enable == 1) {
    tx_data[1] |= ((settings.gyro_FIFO_decimation & 0x07) << 3);
  }
  err_code = data_write(tx_data[0], &tx_data[1] ,1, 1);
  // APP_ERROR_CHECK(err_code);

  // configure sensor hub (if any)
  // set decimation and ONLY_HIGH_DATA bit here
  // tx_data[0] = FIFO_CTRL4;

  // configure FIFO_CTRL5 register
  tx_data[0] = FIFO_CTRL5;
  // set FIFO ODR
  tx_data[1] = 0;
  switch(settings.FIFO_samplerate) {
    default:
    case 13:
            tx_data[1] |= LSM6DS3_IMU_ODR_FIFO_13Hz;
            break;

    case 26:
            tx_data[1] |= LSM6DS3_IMU_ODR_FIFO_26Hz;
            break;

    case 52:
            tx_data[1] |= LSM6DS3_IMU_ODR_FIFO_52Hz;
            break;

    case 104:
            tx_data[1] |= LSM6DS3_IMU_ODR_FIFO_104Hz;
            break;

    case 208:
            tx_data[1] |= LSM6DS3_IMU_ODR_FIFO_208Hz;
            break;

    case 416:
            tx_data[1] |= LSM6DS3_IMU_ODR_FIFO_416Hz;
            break;

    case 833:
            tx_data[1] |= LSM6DS3_IMU_ODR_FIFO_833Hz;
            break;

    case 1660:
            tx_data[1] |= LSM6DS3_IMU_ODR_FIFO_1660Hz;
            break;

    case 3330:
            tx_data[1] |= LSM6DS3_IMU_ODR_FIFO_3330Hz;
            break;

    case 6660:
            tx_data[1] |= LSM6DS3_IMU_ODR_FIFO_6660Hz;
            break;
  }

  // set FIFO mode
  switch(settings.FIFO_mode) {
    default:
    case 0:
          tx_data[1] |= LSM6DS3_IMU_FIFO_MODE_BYPASS;
          break;

    case 1:
            tx_data[1] |= LSM6DS3_IMU_FIFO_MODE_FIFO;
            break;

    case 3:
            tx_data[1] |= LSM6DS3_IMU_FIFO_MODE_STF;
            break;

    case 4:
            tx_data[1] |= LSM6DS3_IMU_FIFO_MODE_BTS;
            break;

    case 6:
            tx_data[1] |= LSM6DS3_IMU_FIFO_MODE_STREAM;
            break;
  }
  err_code = data_write(tx_data[0], &tx_data[1] ,1, 1);
  // APP_ERROR_CHECK(err_code);
}

/**
 * @brief function to read FIFO status
 */
uint16_t LSM6DS3_read_FIFO_status(void)
{
  nrfx_err_t err_code;
  uint8_t data[2];
  //uint8_t tx_data[2];
  uint16_t status = 0;

  /*// set BDU bit in CTRL3_C registers
  tx_data[0] = CTRL3_C;
  tx_data[1] = 0x40;
  err_code = data_write(tx_data[0], &tx_data[1] ,1, 1);
  // APP_ERROR_CHECK(err_code);*/

  // read FIFO_STATUS1 and FIFO_STATUS2 registers
  // err_code = read_register(p_twim_sensors, LSM6DS3_ADDR, FIFO_STATUS1, data, sizeof(data), true);
  err_code = data_read(FIFO_STATUS1, data, sizeof(data), 1);
  // APP_ERROR_CHECK(err_code);
  status = (data[1] << 8) | data[0];

  return status;
}

/**
 * @brief function to read FIFO buffer
 */
uint16_t LSM6DS3_read_FIFO_buffer()
{
  nrfx_err_t err_code;
  uint8_t read_data[2];
  uint16_t data = 0;

  // read FIFO_DATA_OUT_L and FIFO_DATA_OUT_H registers
  // err_code = read_register(p_twim_sensors, LSM6DS3_ADDR, FIFO_DATA_OUT_L, read_data, sizeof(read_data), true);
  err_code = data_read(FIFO_DATA_OUT_L, read_data, sizeof(read_data), 1);
  // APP_ERROR_CHECK(err_code);
  data = (read_data[1] << 8) | read_data[0];

  return data;
}

/**
 * @brief function to empty FIFO buffer
 */
void LSM6DS3_clear_FIFO_buffer(void)
{
  // Read FIFO data and dump it.
  while((LSM6DS3_read_FIFO_status() & 0x1000) == 0) {
    LSM6DS3_read_FIFO_buffer();
  }
}

/**
 * @brief function to configure tap functionality
 */
void LSM6DS3_tap_detect_config()
{
  nrfx_err_t err_code;
  uint8_t tx_data[2];

  // Enable tap detection on X, Y, Z axis, but do not latch output
  tx_data[0] = TAP_CFG;
  tx_data[1] = 0x0E;
  err_code = data_write(tx_data[0], &tx_data[1] ,1, 1);
  // APP_ERROR_CHECK(err_code);

  // Set tap threshold
  tx_data[0] = TAP_THRS_6D;
  tx_data[1] = 0x03;
  err_code = data_write(tx_data[0], &tx_data[1] ,1, 1);
  // APP_ERROR_CHECK(err_code);

  // Set Duration, Quiet and Shock time windows
  tx_data[0] = INT_DUR2;
  tx_data[1] = 0x7F;
  err_code = data_write(tx_data[0], &tx_data[1] ,1, 1);
  // APP_ERROR_CHECK(err_code);

  // Single & Double tap enabled (SINGLE_DOUBLE_TAP = 1)
  tx_data[0] = WAKE_UP_THRS;
  tx_data[1] = 0x80;
  err_code = data_write(tx_data[0], &tx_data[1] ,1, 1);
  // APP_ERROR_CHECK(err_code);

  // Single tap interrupt driven to INT1 pin -- enable latch
  tx_data[0] = MD2_CFG;
  tx_data[1] = 0x48;
  err_code = data_write(tx_data[0], &tx_data[1] ,1, 1);
  // APP_ERROR_CHECK(err_code);
}
