UnlimitedY/wireless_neural_signal_recording_mouse/(commit log)

2024-12-28 update IMU recording
2025-01-03 update alignment and LC_battery
    [MurataProdList-多层陶瓷电容器 (1).csv]
2025-01-14 update lfp 1khz; lower power mode 0
    [WPT_FPC_XCM_Change(1)(1).pcbdoc]
2025-04-23 duty_update/add mp2710
    [BOM_Power_rhd2132_20250418_2025-04-23.xlsx, IMU.SchDoc, MurataProdList-多层陶瓷电容器 (1).csv, NRF_RHD2132_1813_YBW.PrjPcb, PickAndPlace_rhd2132_20250418_2025-04-23.csv, Power.SchDoc, WPT_FPC_XCM_Change(1)(1).pcbdoc, nrf52840_wlcsp.SchDoc]
2025-05-05 update firmware pripherial
    1。 power consumption（4.2V）：mode 0: 20mW； mode1:45mW； mode2:60mW
    2. lfp： 1khz； spike 20833Hz
2025-05-06 lower power consumption and debug
2025-06-06 update
    继电器 控制磁场开关； 视频记录；mode3 在线滤波等更新
    [wireless_power_test.xlsx]
2025-07-08 update to bq25176 + RC filter
2025-10-27 NeuralRecorder+Habits GUI + ESA& LFP firmware update
    [modelparam.txt]
